Cynopolis/BleedingHeart/Documentation/IMG_20200309_155856__01.jpg

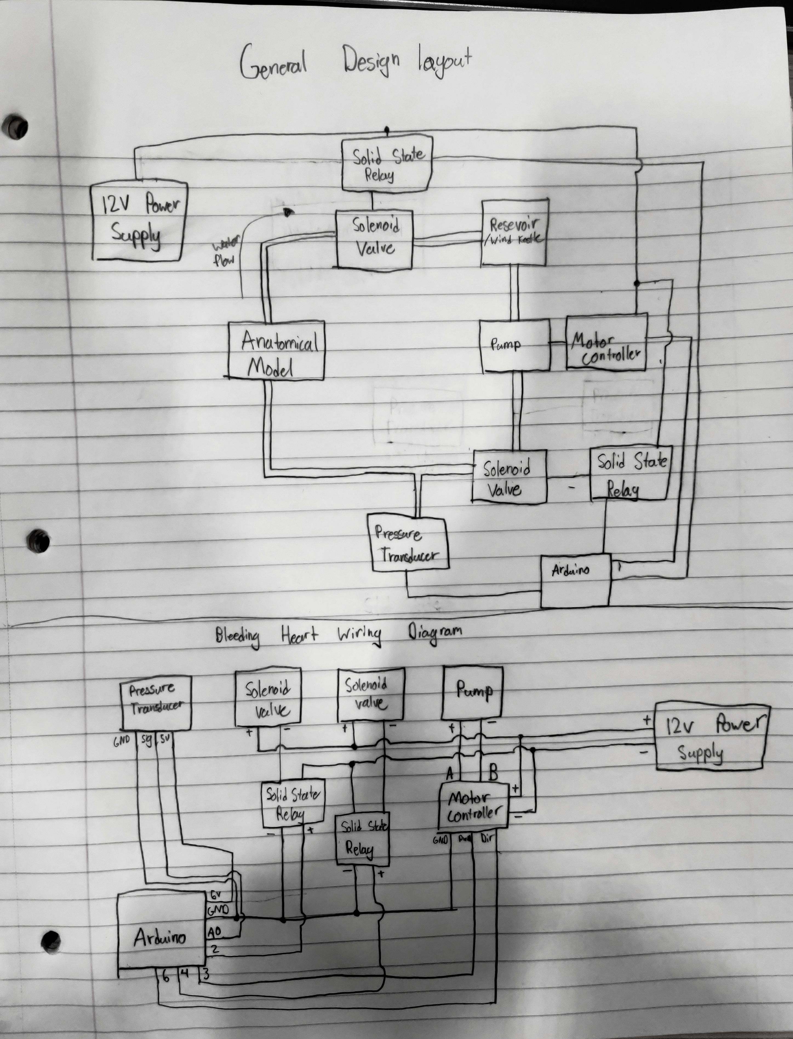
Documentation/IMG_20200309_155856__01.jpg
