Cynopolis/BleedingHeart/Documentation/BOM 3_9_20.xlsx

Part Name | Cost | Quantity | Total Cost | Link | Total
2.1 GPM 60 PSI Pump | $64.99 | 1 | $64.99 | https://www.amazon.com/gp/product/B079VY41XX/ref=ppx_yo_dt_b_asin_title_o07_s00?ie=UTF8&psc=1 | $235.53
12V Solenoid Valve 1/4" NPT | $10.99 | 2 | $21.98 | https://www.amazon.com/gp/product/B018WRJYPY/ref=ppx_yo_dt_b_asin_title_o06_s02?ie=UTF8&psc=1
80 PSI pressure Sensor | $21.49 | 1 | $21.49 | https://www.amazon.com/gp/product/B07KJHJNFQ/ref=ppx_yo_dt_b_asin_title_o06_s00?ie=UTF8&psc=1
Teflon Tape | $0.87 | 1 | $0.87 | https://www.amazon.com/Skylety-Rolls-Thread-Sealant-Inches/dp/B07DRG24D5
Wind Kestle |  | 1 | $0.00 | Unsure of cost, will probably source it from hartstead
5V input Solid State Relay | $12.99 | 2 | $25.98 | https://www.amazon.com/gp/product/B079BGGVYX/ref=ppx_yo_dt_b_asin_title_o02_s03?ie=UTF8&psc=1
11A Motor Controller | $15.75 | 1 | $15.75 | https://www.amazon.com/gp/product/B07CW3JZDH/ref=ppx_yo_dt_b_asin_title_o02_s00?ie=UTF8&psc=1
3/8" Barbed T Fitting | $1.00 | 1 | $1.00 | https://www.amazon.com/gp/product/B07Y34616D/ref=ppx_yo_dt_b_asin_title_o02_s00?ie=UTF8&psc=1
3/8" Barb to 3/8" Male NPT | $6.00 | 2 | $11.99 | https://www.amazon.com/gp/product/B07TWK9WDJ/ref=ppx_yo_dt_b_asin_title_o06_s01?ie=UTF8&psc=1
3/8" Barb to 1/4" NPT | $1.08 | 4 | $4.33 | https://www.amazon.com/gp/product/B07ZNWNQLX/ref=ppx_yo_dt_b_asin_title_o02_s00?ie=UTF8&psc=1
3/8" ID Silicon Tubing 10' | $8.65 | 2 | $17.30 | https://www.amazon.com/gp/product/B01LWSPRCG/ref=ppx_yo_dt_b_asin_title_o06_s00?ie=UTF8&psc=1
3/8" Barb to 1/4" G | $12.99 | 1 | $12.99 | https://www.amazon.com/gp/product/B07WPSLLZT/ref=ppx_yo_dt_b_asin_title_o02_s03?ie=UTF8&psc=1
Clear Plastic Water Tight Bin | $9.44 | 2 | $18.88 | https://www.amazon.com/gp/product/B00KL7VQ7S/ref=ppx_yo_dt_b_asin_title_o05_s00?ie=UTF8&psc=1
Hose Clamps | $0.40 | 11 | $4.39 | https://www.amazon.com/gp/product/B076Q7L1VZ/ref=ppx_yo_dt_b_asin_title_o02_s03?ie=UTF8&psc=1
Arduino Uno | $11.98 | 1 | $11.98 | https://www.amazon.com/ELEGOO-Board-ATmega328P-ATMEGA16U2-Compliant/dp/B01EWOE0UU
Power Block | $0.25 | 6 | $1.50 | Unsure of where these were sourced from. Cost was estimated
Power Block Jumpers | $0.05 | 2 | $0.10 | Unsure of where these were sourced from. Cost was estimated
